abdullahcanakci/network_clock/physical_device/Schematic_JUL_02_2019.pdf

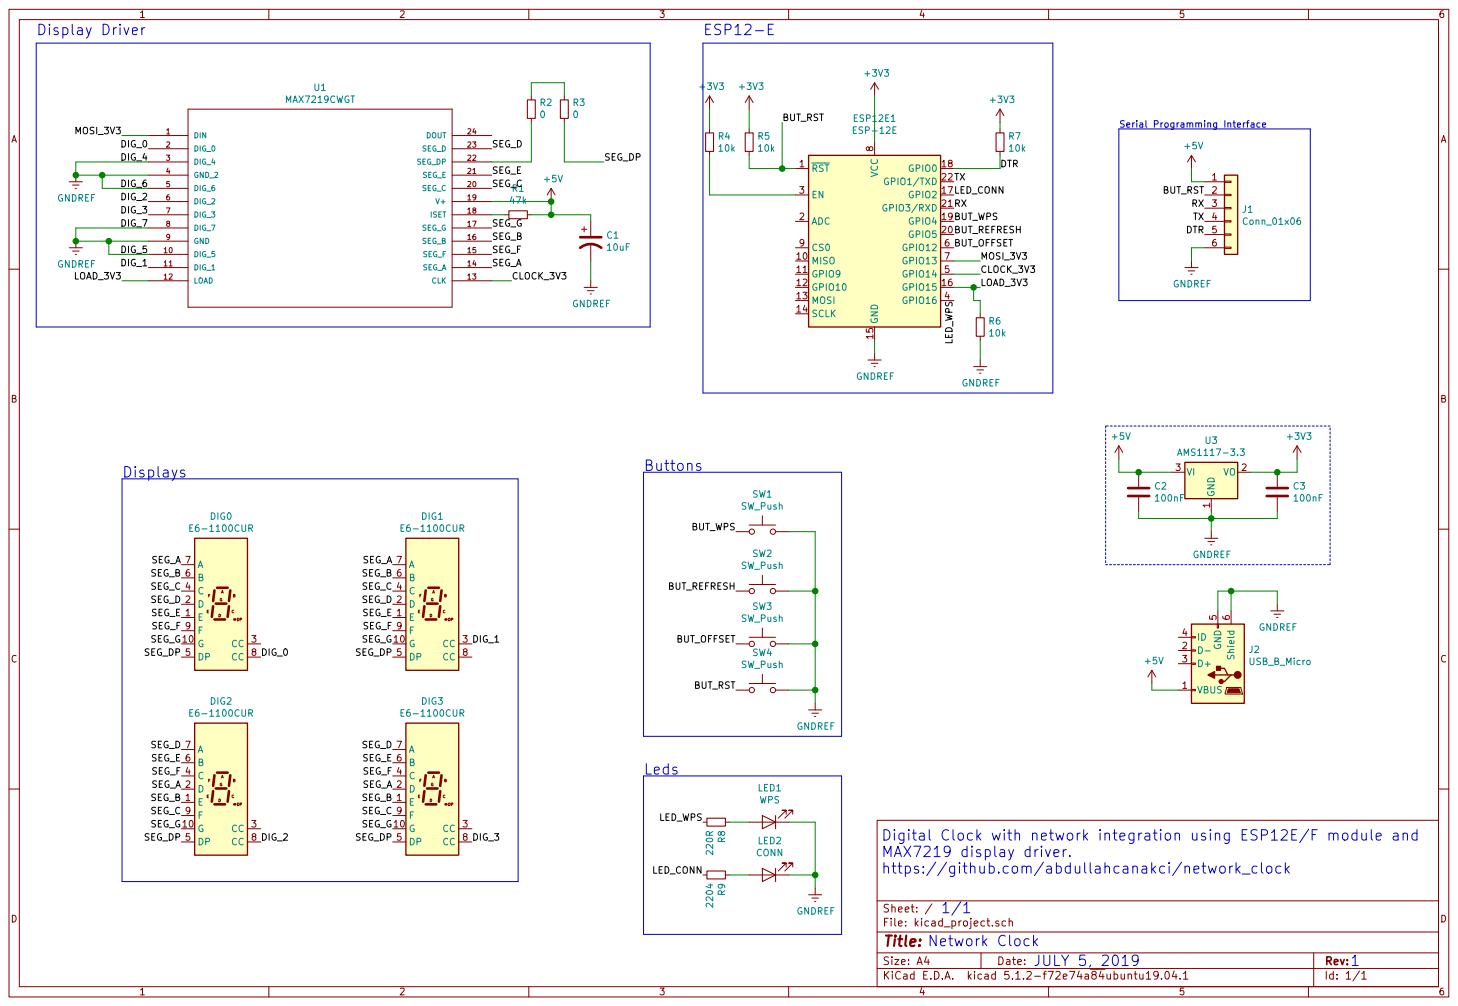
[picture p5: page 1]

1 VO 2 VI 3 U3 AMS1117-3.3 DIN 1 DIG_0 2 DIG_4 3 GND_2 4 DIG_6 5 DIG_2 6 DIG_3 7 DIG_7 8 GND 9 DIG_5 10 DIG_1 11

Digital Clock with network integration using ESP12E/F module and
MAX7219 display driver.
https://github.com/abdullahcanakci/network_clock
