abdullahcanakci/network_clock/PhysicalDevice/kicad_project.kicad_pcb

## KiCad design PhysicalDevice/kicad_project.kicad_pcb (2019-07-01, last stored version)

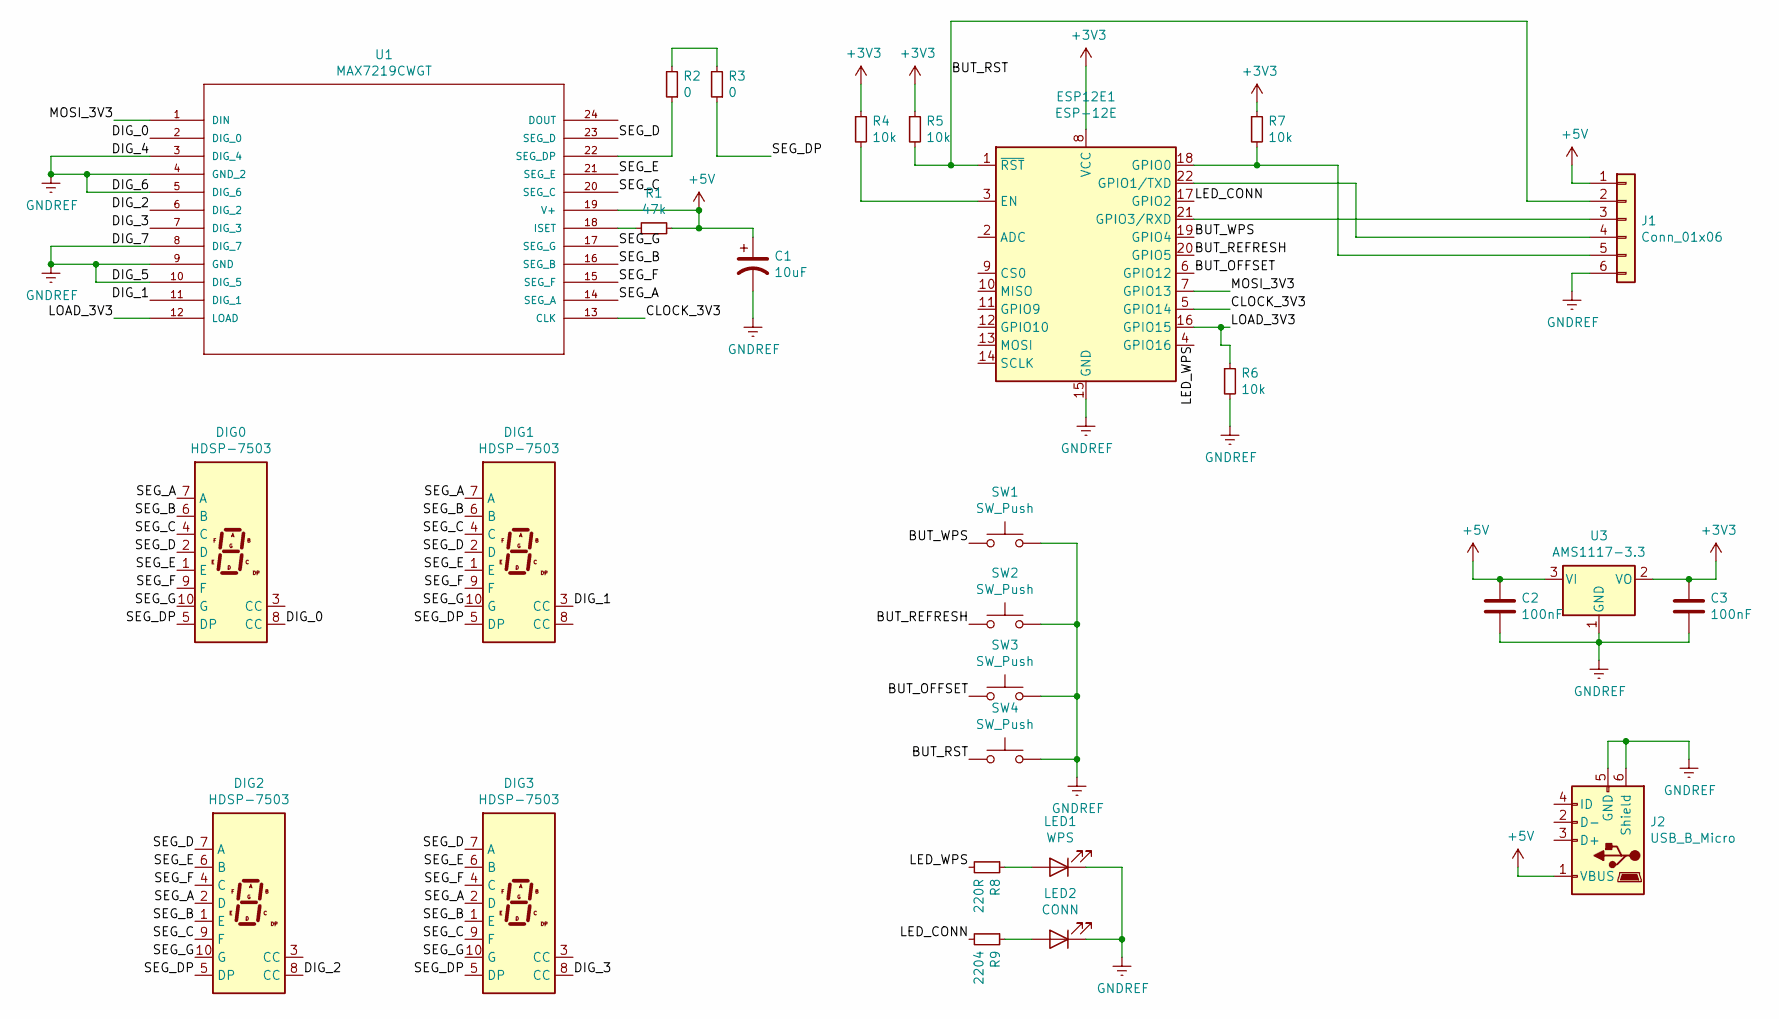
[picture p6: schematic kicad_project.sch]

Parts:
C1: 10uF; CP_Radial_D5.0mm_P2.50mm
C2, C3: 100nF; C_0805_2012Metric
DIG0, DIG1, DIG2, DIG3: HDSP-7503; E6-1100CUR1
ESP12E1: ESP-12E
J1: Conn_01x06; ProgrammingHeader
J2: USB_B_Micro; USB_Micro-B_Molex-105017-0001
LED1: WPS; LED_0805_2012Metric_Pad1.15x1.40mm_HandSolder
LED2: CONN; LED_0805_2012Metric_Pad1.15x1.40mm_HandSolder
R1: 47k; R_0805_2012Metric_Pad1.15x1.40mm_HandSolder
R2, R3: 0; R_0805_2012Metric_Pad1.15x1.40mm_HandSolder
R4, R5, R6, R7: 10k; R_0805_2012Metric_Pad1.15x1.40mm_HandSolder
R8: 220R; R_0805_2012Metric_Pad1.15x1.40mm_HandSolder
R9: 2204; R_0805_2012Metric_Pad1.15x1.40mm_HandSolder
SW1, SW2, SW3, SW4: SW_Push; DTS-3
U1: MAX7219CWGT; 21-0042B_24
U3: AMS1117-3.3; SOT-223-3_TabPin2

Connections:
+3V3: C3.1, ESP12E1.8 (VCC), R4.1, R5.1, R7.1, U3.2 (VO)
+5V: C1.1, C2.1, J1.1, J2.1 (VBUS), R1.2, U1.19 (V+), U3.3 (VI)
/BUT_OFFSET: ESP12E1.6 (GPIO12), SW3.1
/BUT_REFRESH: ESP12E1.20 (GPIO5), SW2.1
/BUT_RST: ESP12E1.1 (~RST), J1.2, R5.2, SW4.1
/BUT_WPS: ESP12E1.19 (GPIO4), SW1.1
/CLOCK_3V3: ESP12E1.5 (GPIO14), U1.13 (CLK)
/DIG_0: DIG0.8 (CC), U1.2 (DIG_0)
/DIG_1: DIG1.3 (CC), U1.11 (DIG_1)
/DIG_2: DIG2.8 (CC), U1.6 (DIG_2)
/DIG_3: DIG3.8 (CC), U1.7 (DIG_3)
/LED_CONN: ESP12E1.17 (GPIO2), R9.2
/LED_WPS: ESP12E1.4 (GPIO16), R8.2
/LOAD_3V3: ESP12E1.16 (GPIO15), R6.1, U1.12 (LOAD)
/MOSI_3V3: ESP12E1.7 (GPIO13), U1.1 (DIN)
/SEG_A: DIG0.7 (A), DIG1.7 (A), DIG2.2 (D), DIG3.2 (D), U1.14 (SEG_A)
/SEG_B: DIG0.6 (B), DIG1.6 (B), DIG2.1 (E), DIG3.1 (E), U1.16 (SEG_B)
/SEG_C: DIG0.4 (C), DIG1.4 (C), DIG2.9 (F), DIG3.9 (F), U1.20 (SEG_C)
/SEG_D: DIG0.2 (D), DIG1.2 (D), DIG2.7 (A), DIG3.7 (A), U1.23 (SEG_D)
/SEG_DP: DIG0.5 (DP), DIG1.5 (DP), DIG2.5 (DP), DIG3.5 (DP), R3.1
/SEG_E: DIG0.1 (E), DIG1.1 (E), DIG2.6 (B), DIG3.6 (B), U1.21 (SEG_E)
/SEG_F: DIG0.9 (F), DIG1.9 (F), DIG2.4 (C), DIG3.4 (C), U1.15 (SEG_F)
/SEG_G: DIG0.10 (G), DIG1.10 (G), DIG2.10 (G), DIG3.10 (G), U1.17 (SEG_G)
GNDREF: C1.2, C2.2, C3.2, ESP12E1.15 (GND), J1.6, J2.5 (GND), J2.6 (Shield), LED1.1 (K), LED2.1 (K), R6.2, SW1.2, SW2.2, SW3.2, SW4.2, U1.3 (DIG_4), U1.4 (GND_2), U1.5 (DIG_6), U1.8 (DIG_7), U1.9 (GND), U1.10 (DIG_5), U3.1 (GND)
unnamed: ESP12E1.3 (EN), R4.2
unnamed: ESP12E1.18 (GPIO0), J1.5, R7.2
unnamed: ESP12E1.21 (GPIO3/RXD), J1.3
unnamed: ESP12E1.22 (GPIO1/TXD), J1.4
unnamed: LED1.2 (A), R8.1
unnamed: LED2.2 (A), R9.1
unnamed: R1.1, U1.18 (ISET)
unnamed: R2.1, U1.22 (SEG_DP)
unnamed: R2.2, R3.2

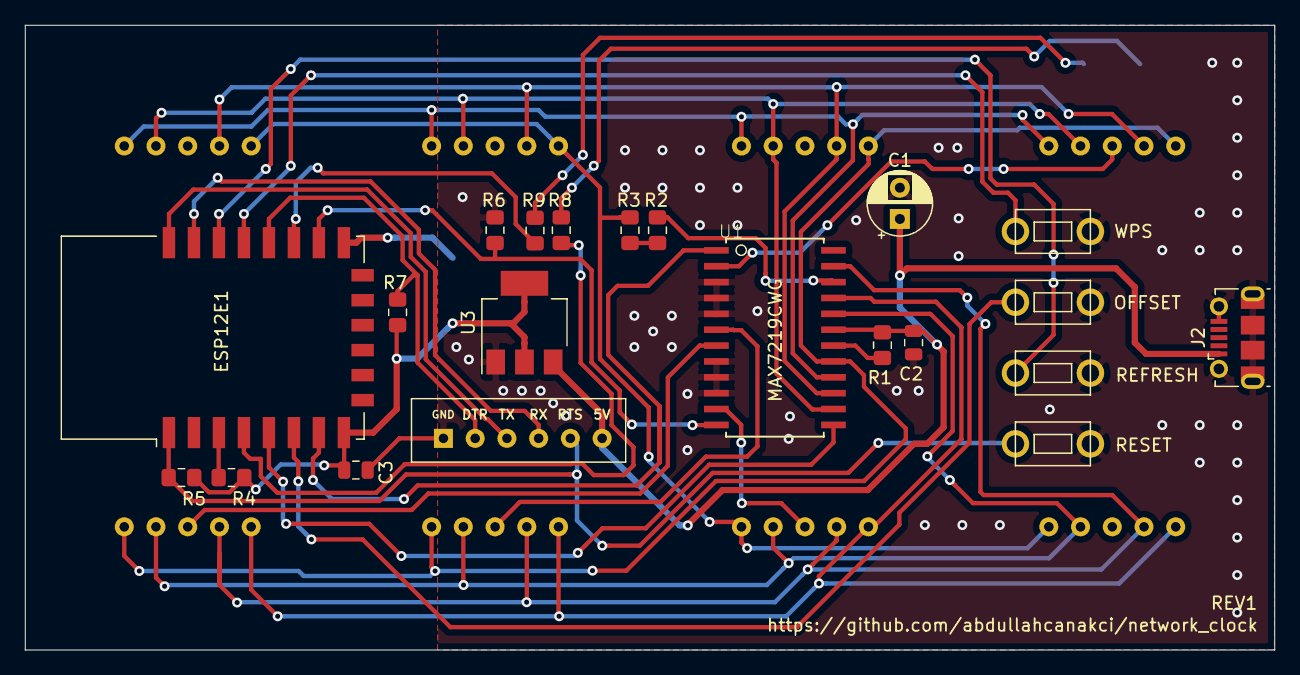
[picture p7: board kicad_project.kicad_pcb from above]

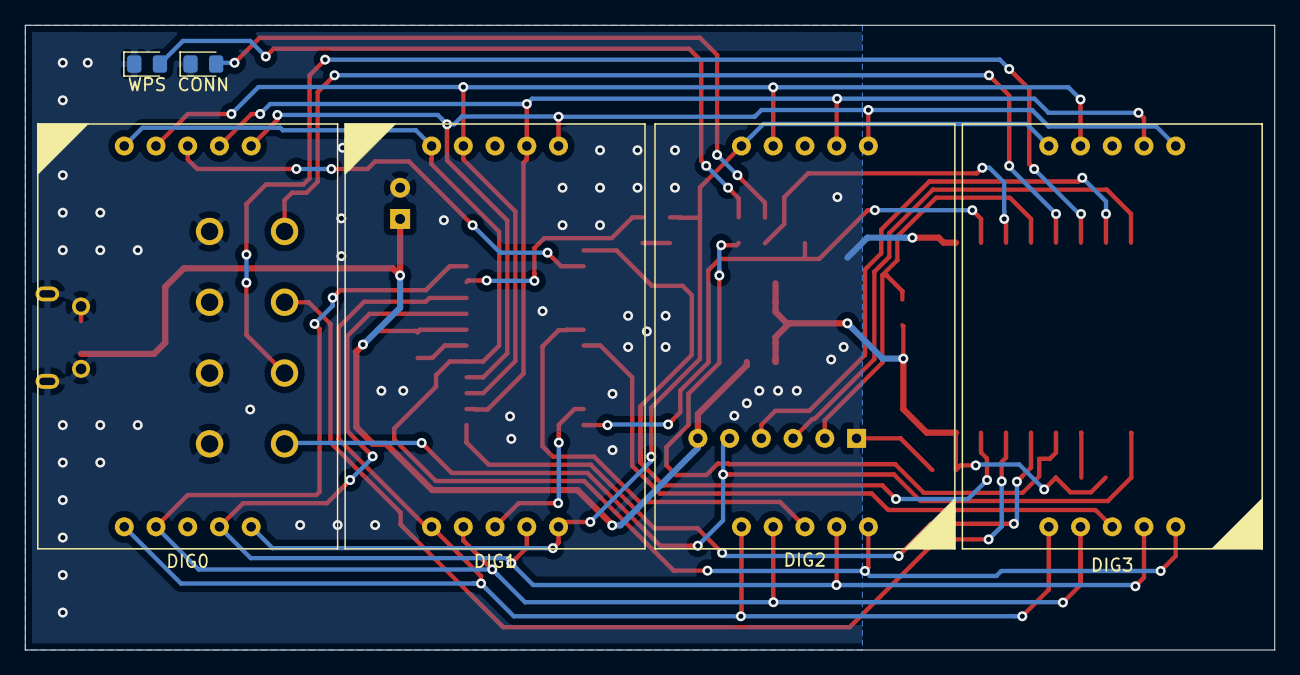
[picture p8: board kicad_project.kicad_pcb from below]

Board: 2 copper layers, 100.0 x 50.0 mm, 27 parts (6 on the bottom side), 33 nets.
