abdullahcanakci/network_clock/(threads)

Thread 1 (2019-07-11):

Web portal mobile interface, pop-up keyboard error

abdullahcanakci, 2019-07-11:
There is an error on HTML or CSS which causes problem when a mobile device activates an input box. Keyboard pops up and viewport resizes. New viewport is now landscape, which creates problems in layouting.
