abdullahcanakci/network_clock/(commit log)

2019-05-26 Specialized controller for display
    Display is now controller by it's own class. Scanning works on first glance didn't check POV. Digit selecting works.
    [main.cpp]
2019-05-26 Nodemcu problems fixed
    Nodemcu created problems when I want to use pins to drive mosfet gates. I fixed it with second 595 to create extra 8 bits of control to control mosfets. Persistence of vision works.
    [main.cpp]
2019-05-27 Interrupt based updates. Time servers and parsing local timekeeping.
    Updates that need to be time sensitive moved to the Ticker from esp8266/arduinocore it works as expected.
    Display, UDP package checking clock dot etc are implemented.
    NTP time server connection implemented. for local timekeeping and parsing RTCLib from Adafruit used. I have used it before, familiar with it. May change with something smaller later.
    Time to display parsing imlemented, works.
2019-06-04 Move to MAX7219
    Okay, at first I was gonna use 595 as drivers and use 1" 7 segment led displays. The problem is there is not much displays with 1 chip per segment. With 595 I was gonna use sole 3V3 logic everywhere. But the only displays I could find were 2 chips per segment in series. So I have move into another logic level and max7219 was more reasonable on the 5V area.
    [SerialDriver.cpp, SerialDriver.h, main.cpp]
2019-06-04 Fixed dot working.
    Relocated some code
    [main.cpp]
2019-06-05 Updated readme. Schematic and PCB added
2019-06-15 RTClib name mismatch fixed. Interrupts are moved into flag based events within loop()
    [main.cpp]
2019-06-21 implemented rudimentary interrupt debouncing
2019-06-21 HW interrupt based Debounce removed.
2019-06-21 implemented refresh button and respective action
2019-06-24 init physical device
    [kicad_project.kicad_pcb, kicad_project.sch]
2019-06-25 created schematic and routed pcb
2019-06-25 Board fully routed. Gerber file generated.
    [kicad_project.kicad_pcb, kicad_project.sch]
2019-06-26 added an extra button, 2 leds.
2019-06-26 added leds and rerouted some bits to be more tidy
    [kicad_project.kicad_pcb, kicad_project.sch]
2019-07-01 pre track witdh change
    [kicad_project.kicad_pcb, kicad_project.sch]
2019-07-01 changed min routing size from 0.25mm(~9.8mil) to 0.35(~13.4mil)
    [kicad_project.kicad_pcb, kicad_project.sch]
2019-07-02 removed kicad files. To much Clutter. Will update Gerber accordinly
    [kicad_project.kicad_pcb, kicad_project.sch]
2019-07-02 Added Gerber
2019-07-02 Removed Kicad Folder
    [kicad_project.kicad_pcb, kicad_project.sch]
2019-07-04 Added schematic and updated readme
2019-07-09 Persistence of credentials are implemented. Portal device interaction implemented.
2019-07-09 Fixed an issue where writing to a file created an EOM marker, before EOL one. Changed to CSV. reorganized some files.
    [main.cpp]
2019-07-10 Updated PCB with mounting holes. Larger PCB.
2019-07-12 Removed 'Ticker'\n\n Removed library ticker. Implemented own solution. Interrupts didn't worked as well as I hoped with wifi stack
    [main.cpp, main.h]
2019-07-15 Moved Interruption init out of setup
2019-07-15 Implemented boot modes.
    Implemented different boot modes based on button inputs.
    Fixed edge cases on time based functions routine.
    Time left untouched. Time offset done on buffer parsing.
    Credentials file restore implemented.
    WPS connection edge case errors fixed.
    WPS conn. info on screen
    Implemented AP to configure device.
    [main.cpp, main.h]
2019-08-03 Added device pictures and updated readme
